vasavbn2/ECE445/README.md

# ECE445
This is our repo for our ECE445 Key FOB project!

## Week of 9/23/24
Discussed our proposal in meeting with our TA.
Next steps: Perform tolerance analysis and begin work on design document.

## Week of 9/30/24
Discussed the design document and design review process with our TA. Working on the proposal regrade, including tolerance analysis and ethics.
Next steps: Complete schematics in KiCad so we have complete schematics and BOMs for our 2 boards. Finish composing the design document.

## Week of 10/7/24
Finalized schematics and started layouts

## Week of 10/14/24
Completed fob layout
BOM for fob: https://www.digikey.com/short/3907nrjb
