vasavbn2/ECE445/ToleranceAnalysis.pdf

## 1 Current Consumption When Off (1 month)

| The latch IC (MAX16054) consumes 7 µA.
| The LDO consumes less than 1 µA.
| 1 month is 720 hours, we will ignore the fact that during some of this
duration the device will be active

Iof f = 8µA ×

1mA
1000µA × 720 hours/month = 5.75 mAh/month

## 2 Active Current Consumption Per Interaction

| The latch IC (MAX16054) consumes 0.4 mA.
| The MCU consumes at most 4 mA for running code from flash memory
with 48 MHz clock, SPI requires 0.2 mA, the GPIOs will require 0.1 mA each and there are 4.

The LDO efficiency is calculated as Vout
Vin

=

2.8
3 = 0.93. This means that
the current requirement for the MCU and RF transceiver combined should be multiplied by 1.075.

The RF transceiver consumes 14.7 mA in RX mode and 30 mA in TX mode.

We estimate the total time of operation for one interaction to be 2 seconds, or 0.0006 hours. This consists of:

| 0.6 seconds (0.0002 hours) in RX mode.
| 1.4 seconds (0.0004 hours) in TX mode.

The total current consumption per interaction is:

Ilatch = 0.4 mA × 0.0006 hours = 0.00024 mAh

IMCU = 1.075((4 + 0.2 + 0.4) mA × 0.0006 hours) = 0.002967 mAh

Itransceiver = 1.075 × ((14.7 mA × 0.0002 hours) + (30 mA × 0.0004 hours))

= 0.00294 + 0.012 = 0.0160605 mAh

Iinteraction = Ilatch + IMCU + Itransceiver

Iinteraction = 0.0192675 mAh ≈ 0.0193 mAh/interaction

1

## 3 Monthly Consumption

Assuming 10 interactions per day, the monthly current consumption is:

Imonth = (Ioff) + (10 interactions/day × 30 days/month × Iinteraction)

= 5.75 mAh/month + 5.79 mAh/month

Imonth = 11.54 mAh/month

## 4 Battery Life Estimation

Our target is for the fob to last at least one month on a single battery. We have identified batteries with a capacity greater than 200 mAh. Therefore, the estimated battery life is at least:

tlife =

200 mAh
11.54 mAh/month ≈ 17 months

This is 17x longer than our goal

## 5 Modular Group Example

The group G consists of the non-zero integers in Z7, i.e., G = {1, 2, 3, 4, 5, 6}. We choose g = 3 as the generator. Now, let’s compute the powers of g mod 7:

g

1 = 3¹ mod 7 = 3,

g

2 = 3² mod 7 = 9 mod 7 = 2,

g

3 = 3³ mod 7 = 27 mod 7 = 6,

g

4 = 3⁴ mod 7 = 81 mod 7 = 4,

g

5 = 3⁵ mod 7 = 243 mod 7 = 5,

g

6 = 3⁶ mod 7 = 729 mod 7 = 1.

Thus, the powers of g = 3 mod 7 generate the set {1, 2, 3, 4, 5, 6}, which means g = 3 is a generator of the group G mod 7.

2
