vasavbn2/ECE445/Fob_Design_Files/Fob_Design_Files.kicad_pcb

## KiCad design Fob_Design_Files/Fob_Design_Files.kicad_pcb (2024-11-18)

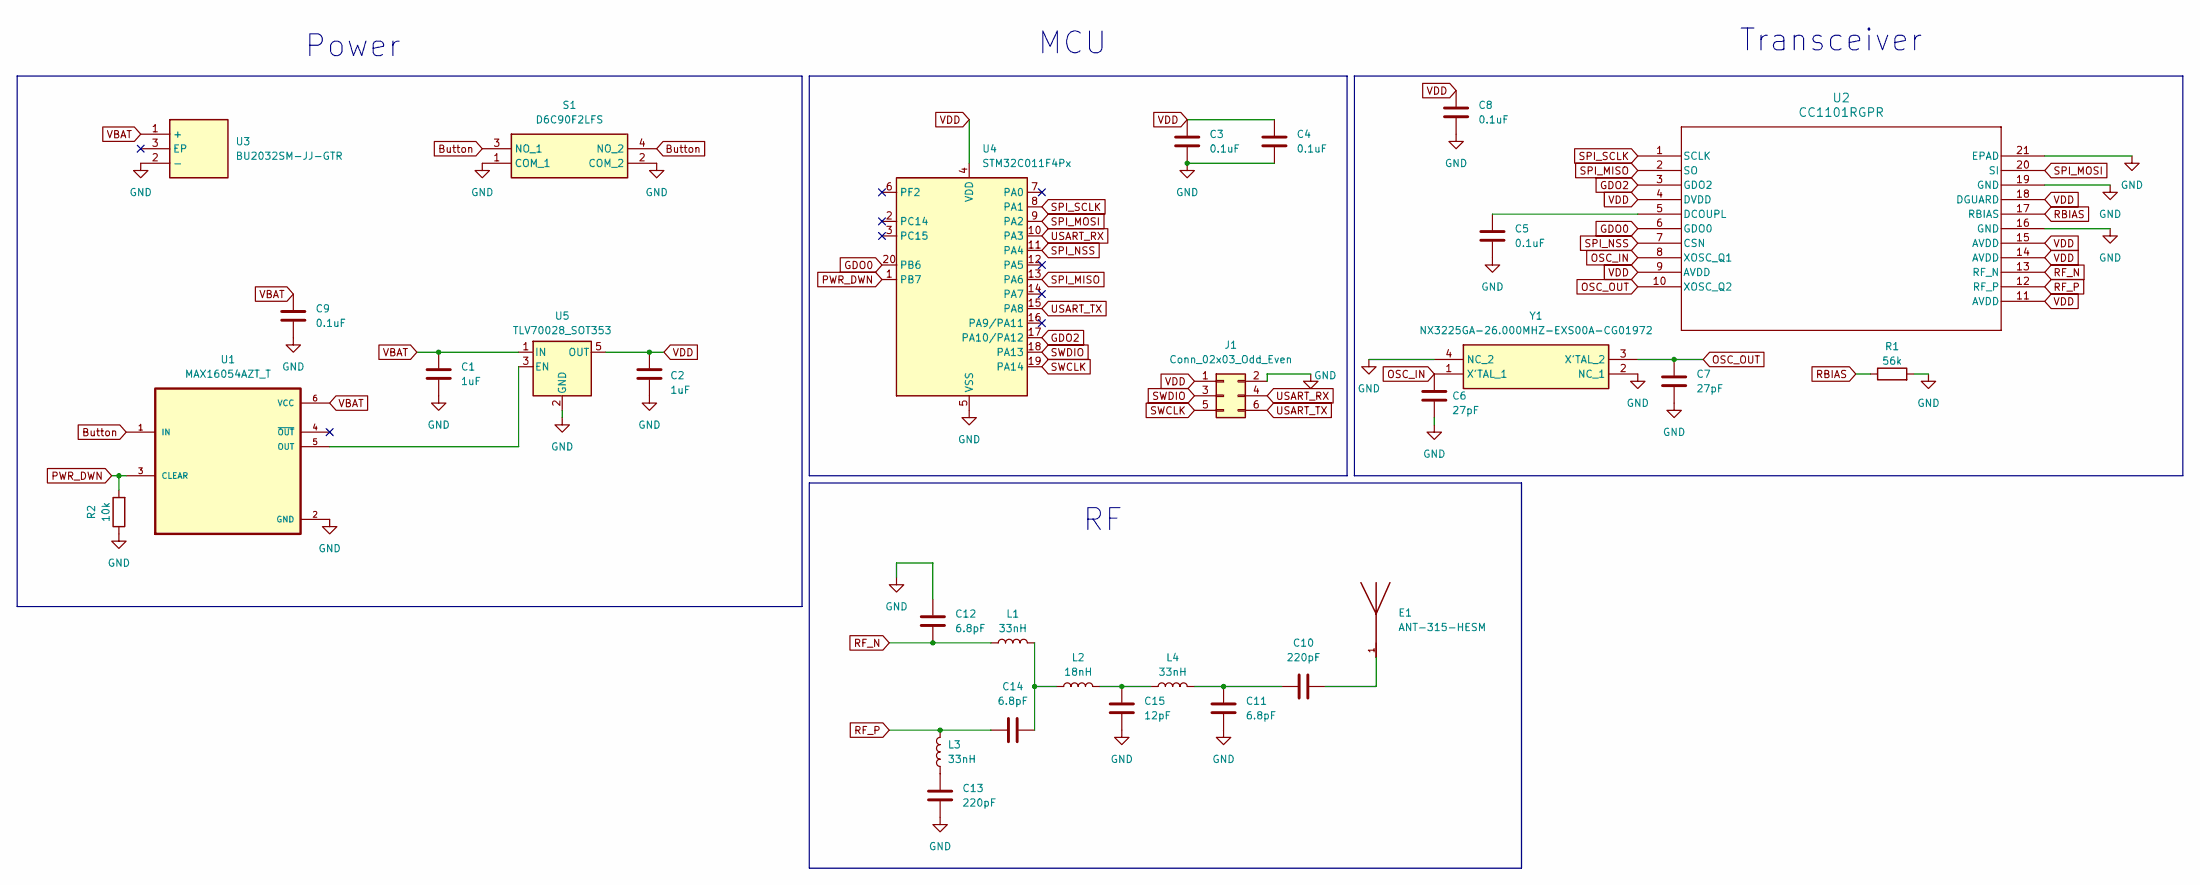
[picture p1: schematic Fob_Design_Files.kicad_sch]

Parts:
C1, C2: 1uF; C_0603_1608Metric
C3, C4, C5, C8, C9: 0.1uF; C_0603_1608Metric
C6, C7: 27pF; C_0603_1608Metric
C10, C13: 220pF; C_0603_1608Metric
C11, C12, C14: 6.8pF; C_0603_1608Metric
C15: 12pF; C_0603_1608Metric
E1: ANT-315-HESM; XDCR_ANT-315-HESM; PARTREV B
J1: Conn_02x03_Odd_Even; PinSocket_2x03_P2.54mm_Vertical
L1, L3, L4: 33nH; L_0603_1608Metric
L2: 18nH; L_0603_1608Metric
R1: 56k; L_0603_1608Metric
R2: 10k; L_0603_1608Metric
S1: D6C90F2LFS; Manufacturer_Part_Number D6C90F2LFS; Mouser Part Number 611-D6C90F2LFS
U1: MAX16054AZT_T; SOT95P275X110-6N
U2: CC1101RGPR; RGP20_2P4X2P4
U3: BU2032SM-JJ-GTR; BU2032SMJJGTR; Manufacturer_Part_Number BU2032SM-JJ-GTR
U4: STM32C011F4Px; TSSOP-20_4.4x6.5mm_P0.65mm
U5: TLV70028_SOT353; SOT-353_SC-70-5
Y1: NX3225GA-26.000MHZ-EXS00A-CG01972; NX3225GA16000MSTDCRG1; Mouser Part Number 344-NX3225GA26MHZEXS

Connections:
Button: S1.3 (NO_1), S1.4 (NO_2), U1.1 (IN)
GDO0: U2.6 (GDO0), U4.20 (PB6)
GDO2: U2.3 (GDO2), U4.17 (PA10/PA12)
GND: C1.2, C2.2, C3.2, C4.2, C5.2, C6.2, C7.2, C8.2, C9.2, C11.1, C12.2, C13.1, C15.1, J1.2, R1.2, R2.1, S1.1 (COM_1), S1.2 (COM_2), U1.2 (GND), U2.16 (GND), U2.19 (GND), U2.21 (EPAD), U3.2 (-), U4.5 (VSS), U5.2 (GND), Y1.2 (NC_1), Y1.4 (NC_2)
unnamed: C10.1, C11.2, L4.2
unnamed: C10.2, E1.1
unnamed: C13.2, L3.1
unnamed: C14.1, L1.2, L2.1
unnamed: C15.2, L2.2, L4.1
unnamed: U1.5 (OUT), U5.3 (EN)
unnamed: C5.1, U2.5 (DCOUPL)
OSC_IN: C6.1, U2.8 (XOSC_Q1), Y1.1 (X'TAL_1)
OSC_OUT: C7.1, U2.10 (XOSC_Q2), Y1.3 (X'TAL_2)
PWR_DWN: R2.2, U1.3 (CLEAR), U4.1 (PB7)
RBIAS: R1.1, U2.17 (RBIAS)
RF_N: C12.1, L1.1, U2.13 (RF_N)
RF_P: C14.2, L3.2, U2.12 (RF_P)
SPI_MISO: U2.2 (SO), U4.13 (PA6)
SPI_MOSI: U2.20 (SI), U4.9 (PA2)
SPI_NSS: U2.7 (CSN), U4.11 (PA4)
SPI_SCLK: U2.1 (SCLK), U4.8 (PA1)
SWCLK: J1.5, U4.19 (PA14)
SWDIO: J1.3, U4.18 (PA13)
USART_RX: J1.4, U4.10 (PA3)
USART_TX: J1.6, U4.15 (PA8)
VBAT: C1.1, C9.1, U1.6 (VCC), U3.1 (+), U5.1 (IN)
VDD: C2.1, C3.1, C4.1, C8.1, J1.1, U2.4 (DVDD), U2.9 (AVDD), U2.11 (AVDD), U2.14 (AVDD), U2.15 (AVDD), U2.18 (DGUARD), U4.4 (VDD), U5.5 (OUT)

Notes on the sheet:
Power
MCU
Transceiver

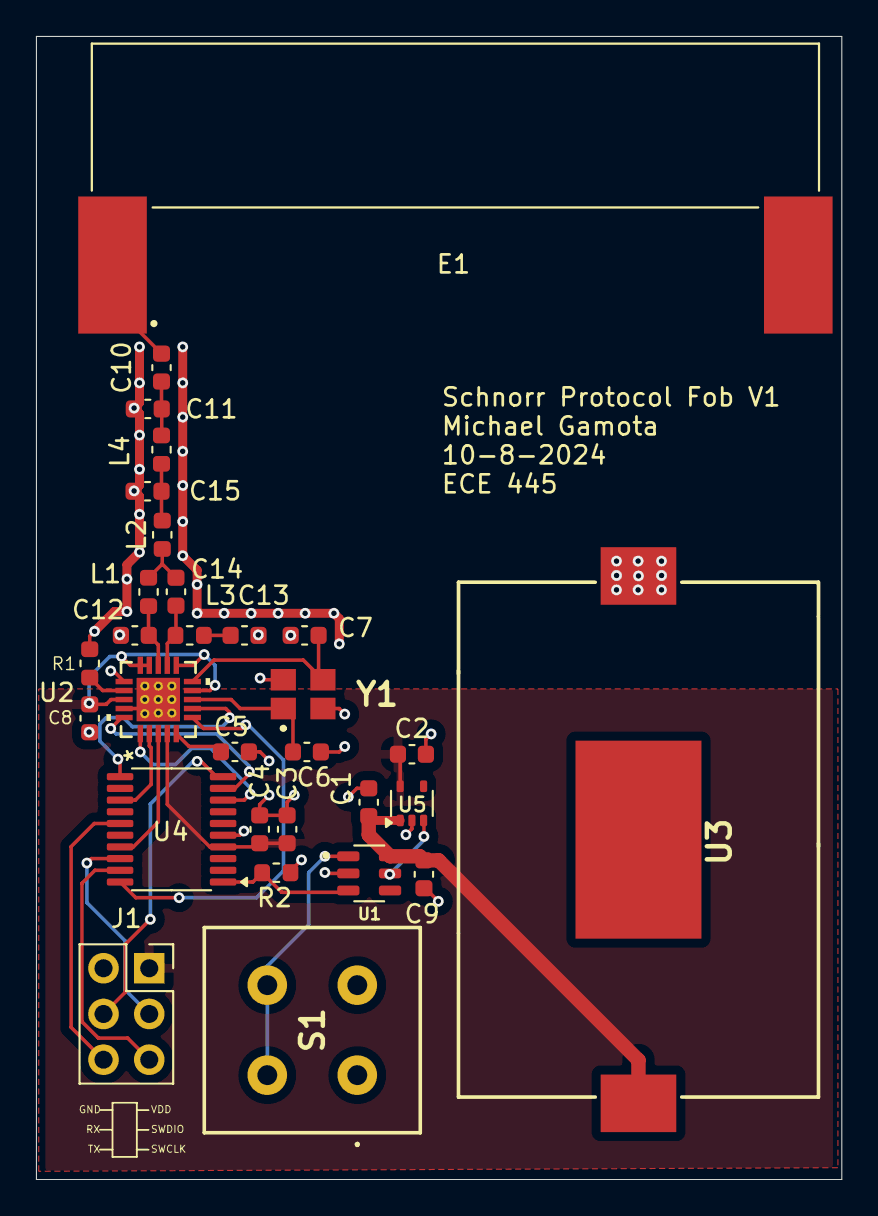
[picture p2: board Fob_Design_Files.kicad_pcb from above]

Board: 2 copper layers, 44.7 x 63.5 mm, 30 parts (0 on the bottom side), 27 nets.
