vasavbn2/ECE445/SMD_Breakout/smd_breadboard.kicad_pcb

## KiCad design SMD_Breakout/smd_breadboard.kicad_pcb (2024-10-29)

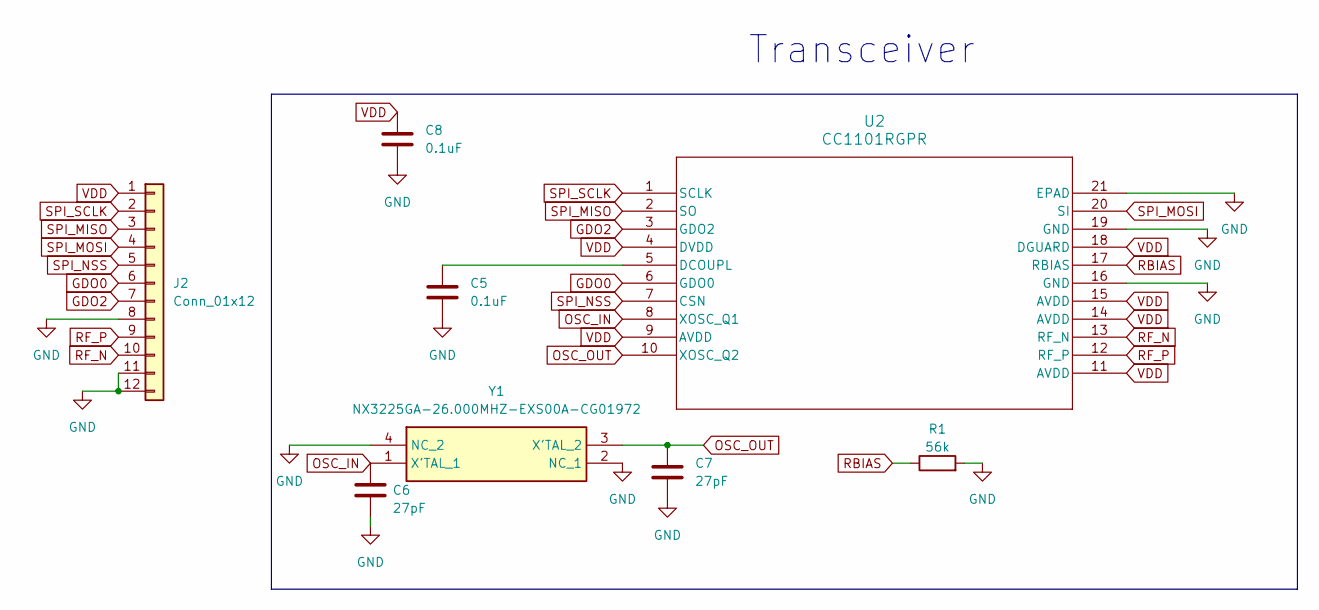
[picture p3: schematic smd_breadboard.kicad_sch]

Parts:
C5, C8: 0.1uF; C_0603_1608Metric
C6, C7: 27pF; C_0603_1608Metric
J2: Conn_01x12; PinSocket_1x12_P2.54mm_Horizontal
R1: 56k; L_0603_1608Metric
U2: CC1101RGPR; Texas_RGP0020H_VQFN-20-1EP_4x4mm_P0.5mm_EP2.4x2.4mm
Y1: NX3225GA-26.000MHZ-EXS00A-CG01972; NX3225GA16000MSTDCRG1; Mouser Part Number 344-NX3225GA26MHZEXS

Connections:
GDO0: J2.6, U2.6 (GDO0)
GDO2: J2.7, U2.3 (GDO2)
GND: C5.2, C6.2, C7.2, C8.2, J2.8, J2.11, J2.12, R1.2, U2.16 (GND), U2.19 (GND), U2.21 (EPAD), Y1.2 (NC_1), Y1.4 (NC_2)
unnamed: C5.1, U2.5 (DCOUPL)
OSC_IN: C6.1, U2.8 (XOSC_Q1), Y1.1 (X'TAL_1)
OSC_OUT: C7.1, U2.10 (XOSC_Q2), Y1.3 (X'TAL_2)
RBIAS: R1.1, U2.17 (RBIAS)
RF_N: J2.10, U2.13 (RF_N)
RF_P: J2.9, U2.12 (RF_P)
SPI_MISO: J2.3, U2.2 (SO)
SPI_MOSI: J2.4, U2.20 (SI)
SPI_NSS: J2.5, U2.7 (CSN)
SPI_SCLK: J2.2, U2.1 (SCLK)
VDD: C8.1, J2.1, U2.4 (DVDD), U2.9 (AVDD), U2.11 (AVDD), U2.14 (AVDD), U2.15 (AVDD), U2.18 (DGUARD)

Notes on the sheet:
Transceiver

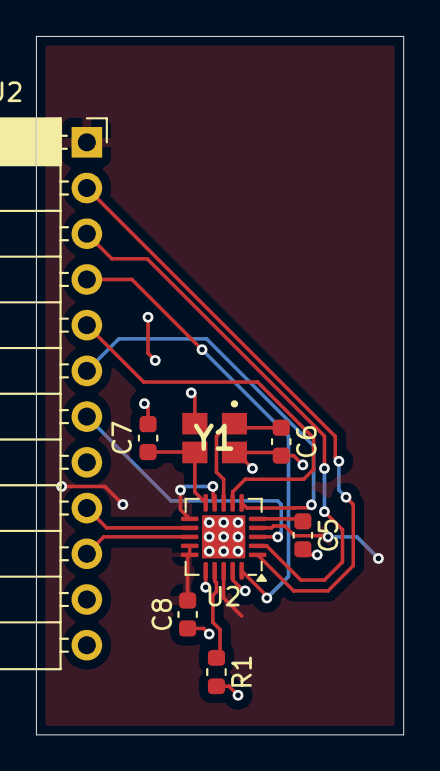
[picture p4: board smd_breadboard.kicad_pcb from above]

Board: 2 copper layers, 20.4 x 38.8 mm, 8 parts (0 on the bottom side), 14 nets.
