vasavbn2/ECE445/Verification_Unit/verification_unit.kicad_pcb

## KiCad design Verification_Unit/verification_unit.kicad_pcb (2024-10-29)

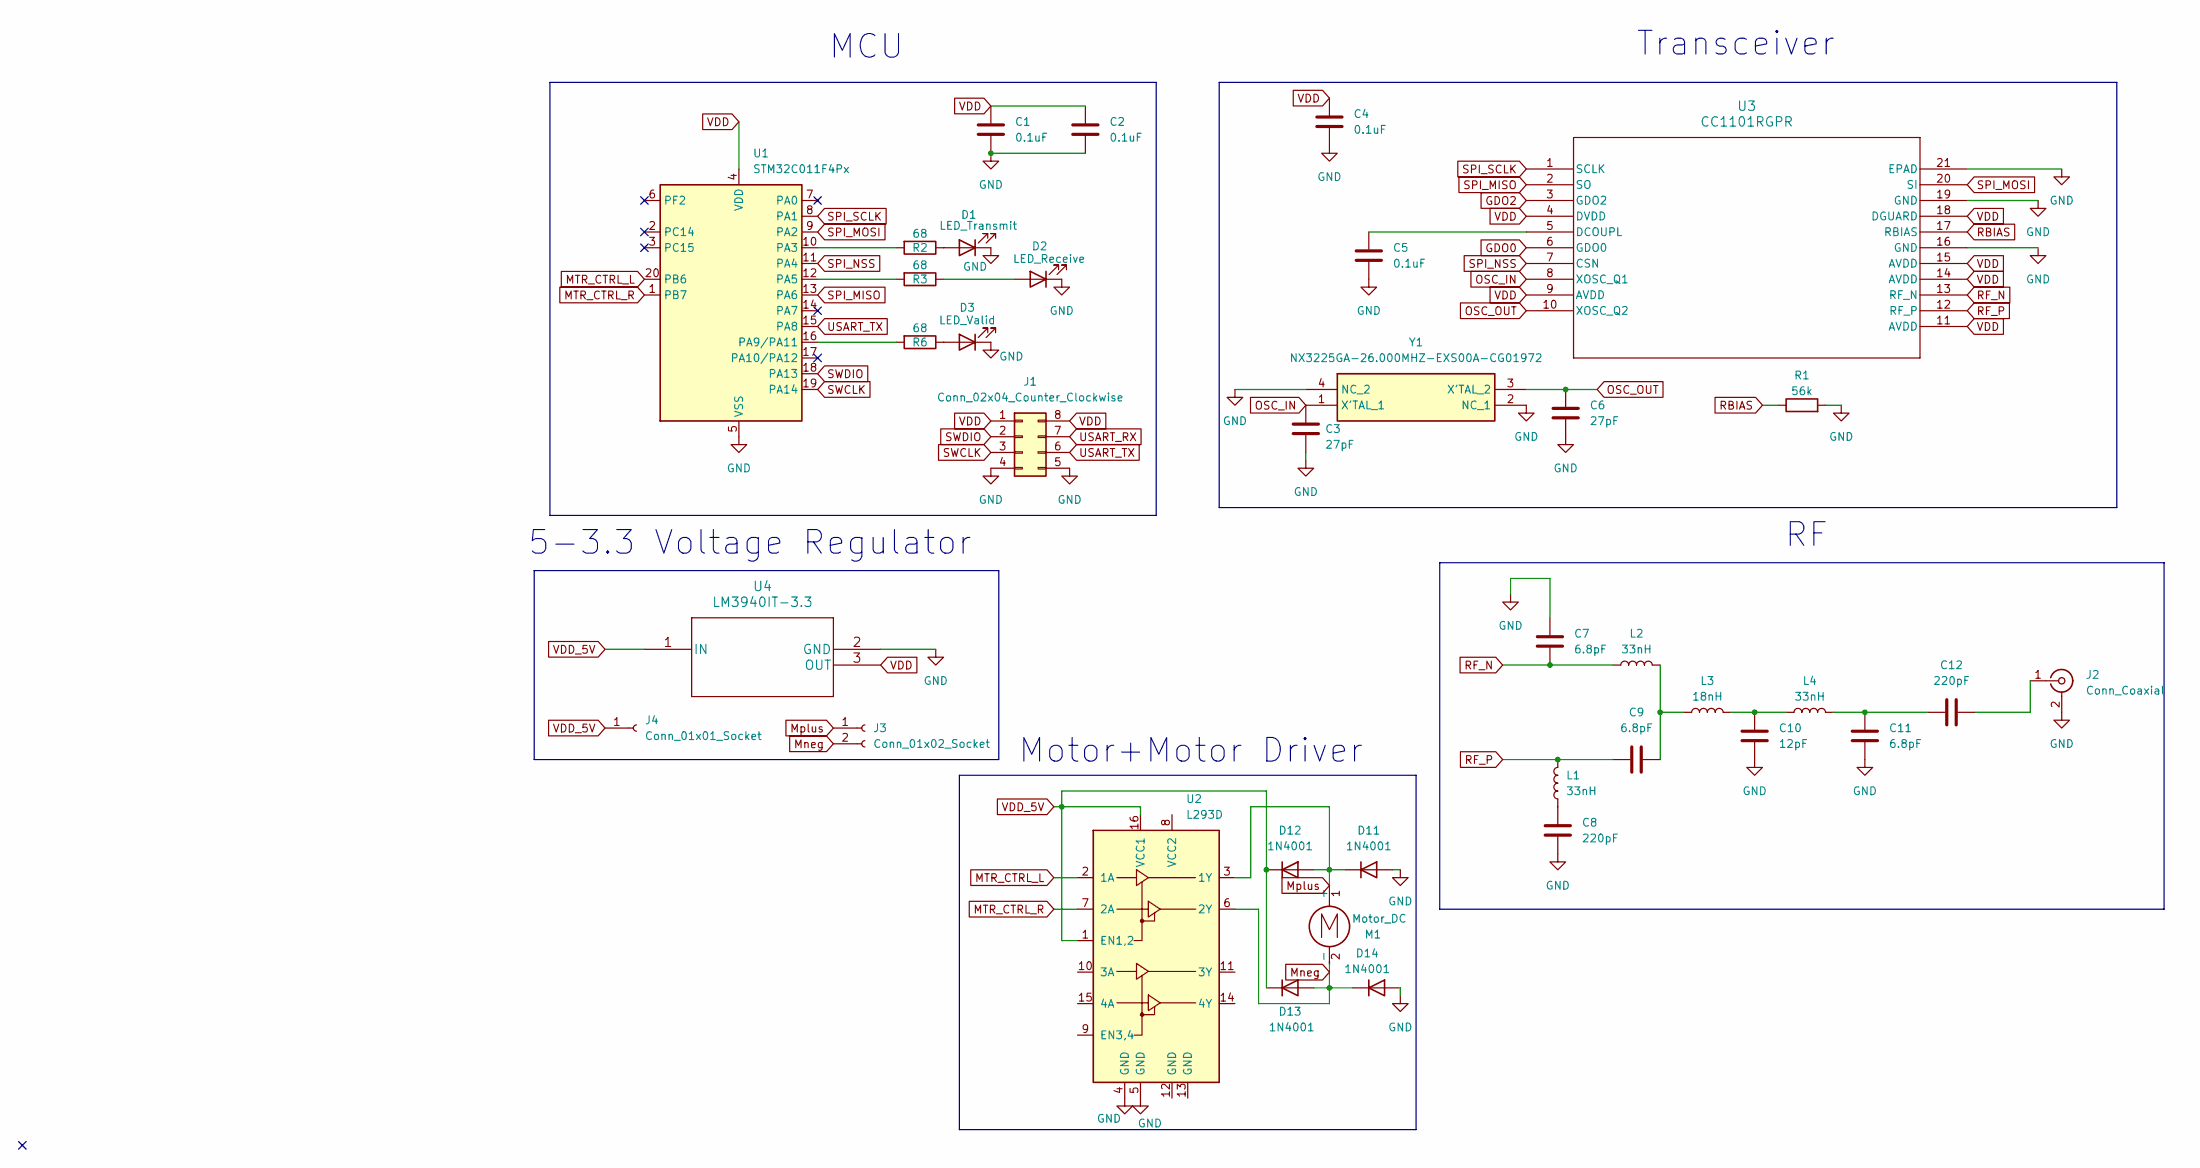
[picture p5: schematic verification_unit.kicad_sch]

Parts:
C1, C2, C4, C5: 0.1uF; C_0805_2012Metric
C3, C6: 27pF; C_0805_2012Metric
C7, C9, C11: 6.8pF; C_0805_2012Metric
C8, C12: 220pF; C_0805_2012Metric
C10: 12pF; C_0805_2012Metric
D1: LED_Transmit; LED_0805_2012Metric
D2: LED_Receive; LED_0805_2012Metric
D3: LED_Valid; LED_0805_2012Metric
D11, D12, D13, D14: 1N4001; D_0805_2012Metric
J1: Conn_02x04_Counter_Clockwise; PinSocket_2x04_P2.54mm_Vertical
J2: Conn_Coaxial; SMA_Amphenol_901-143_Horizontal
J3: Conn_01x02_Socket; PinSocket_1x02_P2.54mm_Vertical
J4: Conn_01x01_Socket; PinSocket_1x01_P2.54mm_Vertical
L1, L2, L4: 33nH; L_0805_2012Metric
L3: 18nH; L_0805_2012Metric
M1: Motor_DC
R1: 56k; C_0805_2012Metric
R2, R3, R6: 68; R_0805_2012Metric
U1: STM32C011F4Px; TSSOP-20_4.4x6.5mm_P0.65mm
U2: L293D; DIP-16_W7.62mm
U3: CC1101RGPR; RGP20_2P4X2P4
U4: LM3940IT-3.3
Y1: NX3225GA-26.000MHZ-EXS00A-CG01972; NX3225GA16000MSTDCRG1; Mouser Part Number 344-NX3225GA26MHZEXS

Connections:
GDO0: U3.6 (GDO0)
GDO2: U3.3 (GDO2)
GND: C1.2, C2.2, C3.2, C4.2, C5.2, C6.2, C7.2, C8.1, C10.1, C11.1, D1.1 (K), D2.1 (K), D3.1 (K), D11.2 (A), D14.2 (A), J1.4, J1.5, J2.2 (Ext), R1.2, U1.5 (VSS), U2.4 (GND), U2.5 (GND), U3.16 (GND), U3.19 (GND), U3.21 (EPAD), U4.2 (GND), Y1.2 (NC_1), Y1.4 (NC_2)
MTR_CTRL_L: U1.20 (PB6), U2.2 (1A)
MTR_CTRL_R: U1.1 (PB7), U2.7 (2A)
Mneg: D13.2 (A), D14.1 (K), J3.2, M1.2 (-), U2.6 (2Y)
Mplus: D11.1 (K), D12.2 (A), J3.1, M1.1 (+), U2.3 (1Y)
unnamed: C8.2, L1.1
unnamed: C9.1, L2.2, L3.1
unnamed: C10.2, L3.2, L4.1
unnamed: C11.2, C12.1, L4.2
unnamed: D1.2 (A), R2.1
unnamed: D2.2 (A), R3.1
unnamed: D3.2 (A), R6.1
unnamed: C12.2, J2.1 (In)
unnamed: R2.2, U1.10 (PA3)
unnamed: R3.2, U1.12 (PA5)
unnamed: R6.2, U1.16 (PA9/PA11)
unnamed: C5.1, U3.5 (DCOUPL)
OSC_IN: C3.1, U3.8 (XOSC_Q1), Y1.1 (X'TAL_1)
OSC_OUT: C6.1, U3.10 (XOSC_Q2), Y1.3 (X'TAL_2)
RBIAS: R1.1, U3.17 (RBIAS)
RF_N: C7.1, L2.1, U3.13 (RF_N)
RF_P: C9.2, L1.2, U3.12 (RF_P)
SPI_MISO: U1.13 (PA6), U3.2 (SO)
SPI_MOSI: U1.9 (PA2), U3.20 (SI)
SPI_NSS: U1.11 (PA4), U3.7 (CSN)
SPI_SCLK: U1.8 (PA1), U3.1 (SCLK)
SWCLK: J1.3, U1.19 (PA14)
SWDIO: J1.2, U1.18 (PA13)
USART_RX: J1.7
USART_TX: J1.6, U1.15 (PA8)
VDD: C1.1, C2.1, C4.1, J1.1, J1.8, U1.4 (VDD), U3.4 (DVDD), U3.9 (AVDD), U3.11 (AVDD), U3.14 (AVDD), U3.15 (AVDD), U3.18 (DGUARD), U4.3 (OUT)
VDD_5V: D12.1 (K), D13.1 (K), J4.1, U2.1 (EN1,2), U2.16 (VCC1), U4.1 (IN)

Notes on the sheet:
Transceiver
MCU
Motor+Motor Driver
5-3.3 Voltage Regulator

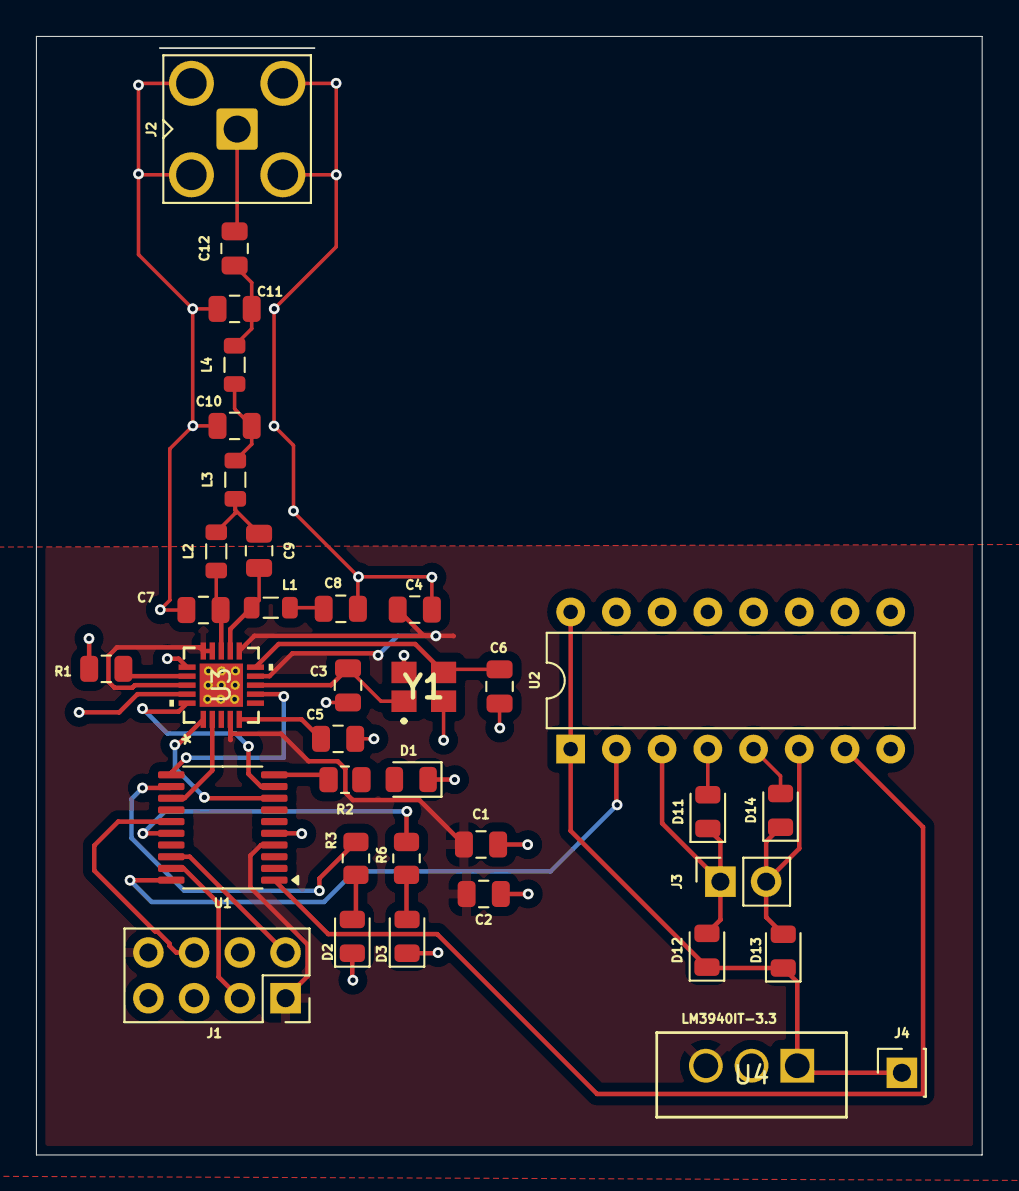
[picture p6: board verification_unit.kicad_pcb from above]

Board: 2 copper layers, 52.5 x 62.1 mm, 36 parts (0 on the bottom side), 31 nets.
