vasavbn2/ECE445/Fob_Code/Core/Src/main.c

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
/* Includes ------------------------------------------------------------------*/
#include "main.h"
#include "spi.h"
#include "usart.h"
#include "gpio.h"

/* USER CODE BEGIN Includes */
#include "cc1101.h"
/* USER CODE END Includes */


void SystemClock_Config(void);
/**
  * @brief  The application entry point.
  * @retval int
  */
int main(void)
{

  /* MCU Configuration--------------------------------------------------------*/

  /* Reset of all peripherals, Initializes the Flash interface and the Systick. */
  HAL_Init();

  /* Configure the system clock */
  SystemClock_Config();

  /* Initialize all configured peripherals */
  MX_GPIO_Init();
  MX_USART2_UART_Init();
  MX_SPI1_Init();
  /* USER CODE BEGIN 2 */

  // Power up the CC1101
  Power_up_reset();
  TI_init(&hspi1, CS_GPIO_Port, CS_Pin);

  uint8_t status;
  uint8_t ok = 7;
  uint8_t not_ok = 2;

  // Read the version, make sure it's 0x14
  status = TI_read_status(CCxxx0_VERSION);
  if (status==0x14){
  	  HAL_UART_Transmit(&huart2, &ok, sizeof(ok), 50); // Send to NUCLEO

  }
  else{
  	  HAL_UART_Transmit(&huart2, &not_ok, sizeof(not_ok), 50); // Send to NUCLEO
  }

  // Clear RX buffer

  // Send message: public key, "open", "u" = g^r,

  // Receive challenge

  // Calculate response

  // Send response

  // Power down



  /* USER CODE END 2 */

  /* Infinite loop */
  /* USER CODE BEGIN WHILE */
  while (1)
  {
    /* USER CODE END WHILE */

    /* USER CODE BEGIN 3 */
//	  HAL_Delay(10);
//	  status = TI_read_status(CCxxx0_PARTNUM);
//	  HAL_UART_Transmit(&huart2, &status, sizeof(status), 50); // Send to NUCLEO
//	  HAL_Delay(1000);
//
//	  status = TI_read_status(CCxxx0_FREQEST);
//	  HAL_UART_Transmit(&huart2, &status, sizeof(status), 50); // Send to NUCLEO
//	  HAL_Delay(10);

	  status = TI_read_status(CCxxx0_VERSION);
	  HAL_UART_Transmit(&huart2, &status, sizeof(status), 50); // Send to NUCLEO
	  HAL_Delay(10);

//	  status = TI_read_status(CCxxx0_RXBYTES);
//	  HAL_UART_Transmit(&huart2, &status, sizeof(status), 50); // Send to NUCLEO

  }
  /* USER CODE END 3 */
}

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
