vasavbn2/ECE445/Fob_Code/Core/Inc/main.h

#define CS_Pin GPIO_PIN_4
#define CS_GPIO_Port GPIOA
#define MISO_Pin GPIO_PIN_6
#define MISO_GPIO_Port GPIOA
#define GDO2_Pin GPIO_PIN_12
#define GDO2_GPIO_Port GPIOA
#define GDO0_Pin GPIO_PIN_6
#define GDO0_GPIO_Port GPIOB
