vasavbn2/ECE445/(commit log)

2024-10-01 Created project for fob
    [Fob_Design_Files.kicad_pcb, Fob_Design_Files.kicad_sch]
2024-10-02 Finished schematic
    [Fob_Design_Files.kicad_pcb, Fob_Design_Files.kicad_sch]
2024-10-02 Completed schematic
    [Fob_Design_Files.kicad_pcb, Fob_Design_Files.kicad_sch]
2024-10-02 Updated readme:
    [Fob_Design_Files.kicad_pcb]
2024-10-02 Minor fob schematic changes
    [Fob_Design_Files.kicad_pcb, Fob_Design_Files.kicad_sch]
2024-10-03 Added UART and indicator LEDs
    [Fob_Design_Files.kicad_sch]
2024-10-03 Tolerance anaylsis LaTeX
    [Fob_Design_Files.kicad_pcb, Fob_Design_Files.kicad_sch]
2024-10-03 Adding BOM
    [Fob_Design_BOM.csv]
2024-10-03 verification unit
    [verification_unit.kicad_sch]
2024-10-09 Done with fob layout
    [Fob_Design_Files.kicad_pcb, Fob_Design_Files.kicad_sch]
2024-10-09 Minor changes
    [Fob_Design_Files.kicad_pcb, Fob_Design_Files.kicad_sch]
2024-10-14 New gerbers
    [Fob_Design_Files-B_Cu.gbr, Fob_Design_Files-B_Mask.gbr, Fob_Design_Files-B_Paste.gbr, Fob_Design_Files-B_Silkscreen.gbr, Fob_Design_Files-Edge_Cuts.gbr, Fob_Design_Files-F_Cu.gbr, Fob_Design_Files-F_Mask.gbr, Fob_Design_Files-F_Paste.gbr]
2024-10-29 Adding schnorr Python implementation
    [Fob_Design_Files.kicad_pcb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]
2024-11-10 Adding code
    [Fob_Design_Files.kicad_pcb]
2024-11-18 adding software
    [Fob_Design_Files.kicad_pcb]
