vasavbn2/ECE445/(notices)

Notices in the files:
Fob_Code/Core/Src/main.c:
Copyright (c) 2024 STMicroelectronics.
All rights reserved.
This software is licensed under terms that can be found in the LICENSE file
parts and their libraries:
Copyright 2016 Accelerated Designs. All rights reserved.
